agoalie/BajaElecPCB/Baja2027_RPM/jlc_export/Baja2027_RPM_BOM.csv

Comment | Designator | Footprint | LCSC Part #
100n | C1,C2,C3,C4,C5,C6,C8,C12,C14,C15,C18 | C_0402_1005Metric | C1525
10u | C7 | C_0402_1005Metric | C15525
1u | C9,C16,C17 | C_0402_1005Metric | C52923
15p | C10,C11 | C_0402_1005Metric | C1548
4.7u | C13 | C_0402_1005Metric | C23733
LED | D1,D2,D3,D4,D5,D6 | LED_0603_1608Metric | C2286
SS34 | D7,D8 | D_SMA | C8678
USBLC6-2SC6 | D9 | USBLC6-2SC6 | C7519
Fuse | F1,F2 | MF-NSMF050-2_Fuse | C75464
RJ45 | J1,J6,J7,J8,J9,J10 | RJ45 | C385834
JTAG | J2 | JTAG | C2977596
USB_C_Receptacle_USB2.0_14P | J3 | USB_C_Receptacle_GCT_USB4105-xx-A_16P_TopMnt_Horizontal | C2765186
Micro_SD_Card_Det1 | J4 | Sd Card Slot | C91145
DEBUG PORT | J5 | PinHeader_1x04_P2.54mm_Vertical | C32713270
NMOS | Q1,Q2,Q3,Q4,Q5 | SOT-23 | C282405
4.7k | R1,R2 | R_0402_1005Metric | C25900
0 | R3 | R_0402_1005Metric | C17168
10k | R4,R13,R15,R17,R18,R21,R22 | R_0402_1005Metric | C25744
120 | R5 | R_0402_1005Metric | C25079
5.1k | R6,R7 | R_0402_1005Metric | C25905
47k | R8,R9,R10,R11,R12 | R_0402_1005Metric | C25792
470 | R14,R16,R19,R20,R23,R24 | R_0402_1005Metric | C25117
SW_Push | SW1 | SW_Push_1P1T_XKB_TS-1187A | C318884
SW_DPDT_x2 | SW2 | PinHeader_1x03_P2.54mm_Vertical | C3337081
SW_DIP_x01 | SW3 | CHS-01TB_DIPSWITCH | C2680613
24LC00T-I/OT | U1 | 24LC00T_EEPROM_SOT-23-5_MC_MCH | C2062024
STM32F412RETx | U2 | LQFP-64_10x10mm_P0.5mm | C89374
TCAN332 | U3 | TCAN332 | C2671083
XC6206-3.3V | U4 | SOT-23-3 | C2891841
X32258MOB4SI | Y1 | X32258MOB4SI_8MHz_Crystal | C2682775
