agoalie/BajaElecPCB/Baja2027_RPM/3dmodels/RJ45-TH_L15.9-W15.1-H12.6.step

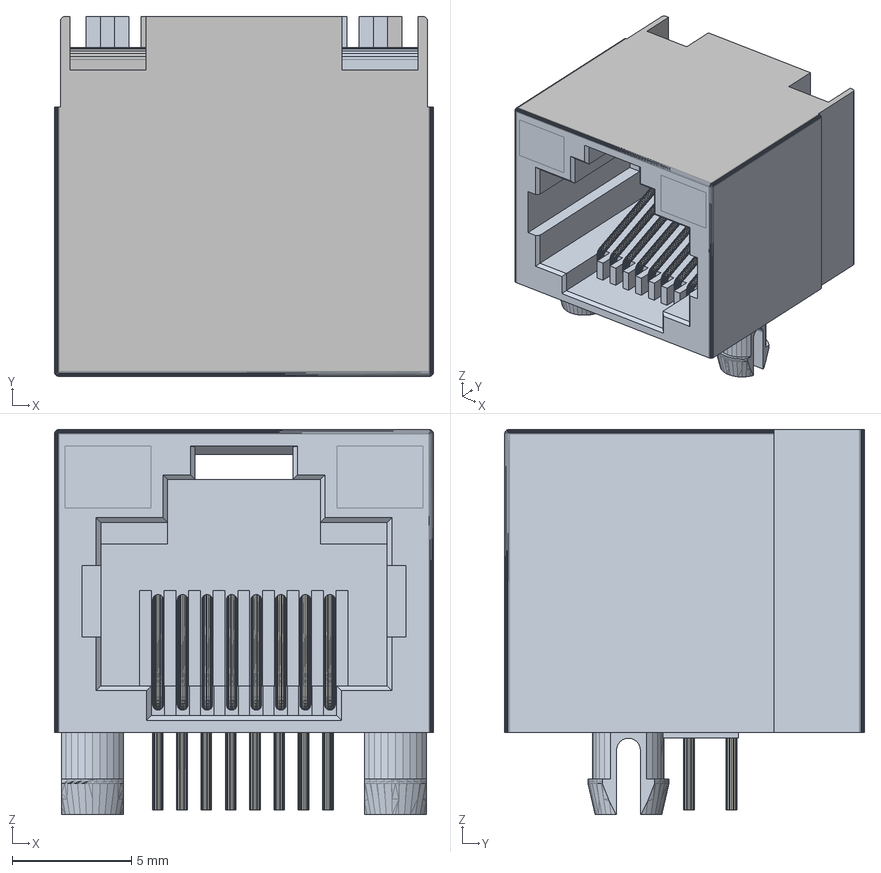
[picture p1: CAD file, 2026-11-05]
Baja2027_RPM/3dmodels/RJ45-TH_L15.9-W15.1-H12.6.step
15.9 x 15.1 x 16.1 mm
