agoalie/BajaElecPCB/Baja2027_RPM/Baja2027_RPM.kicad_pcb

## KiCad design Baja2027_RPM/Baja2027_RPM.kicad_pcb (2026-11-09)

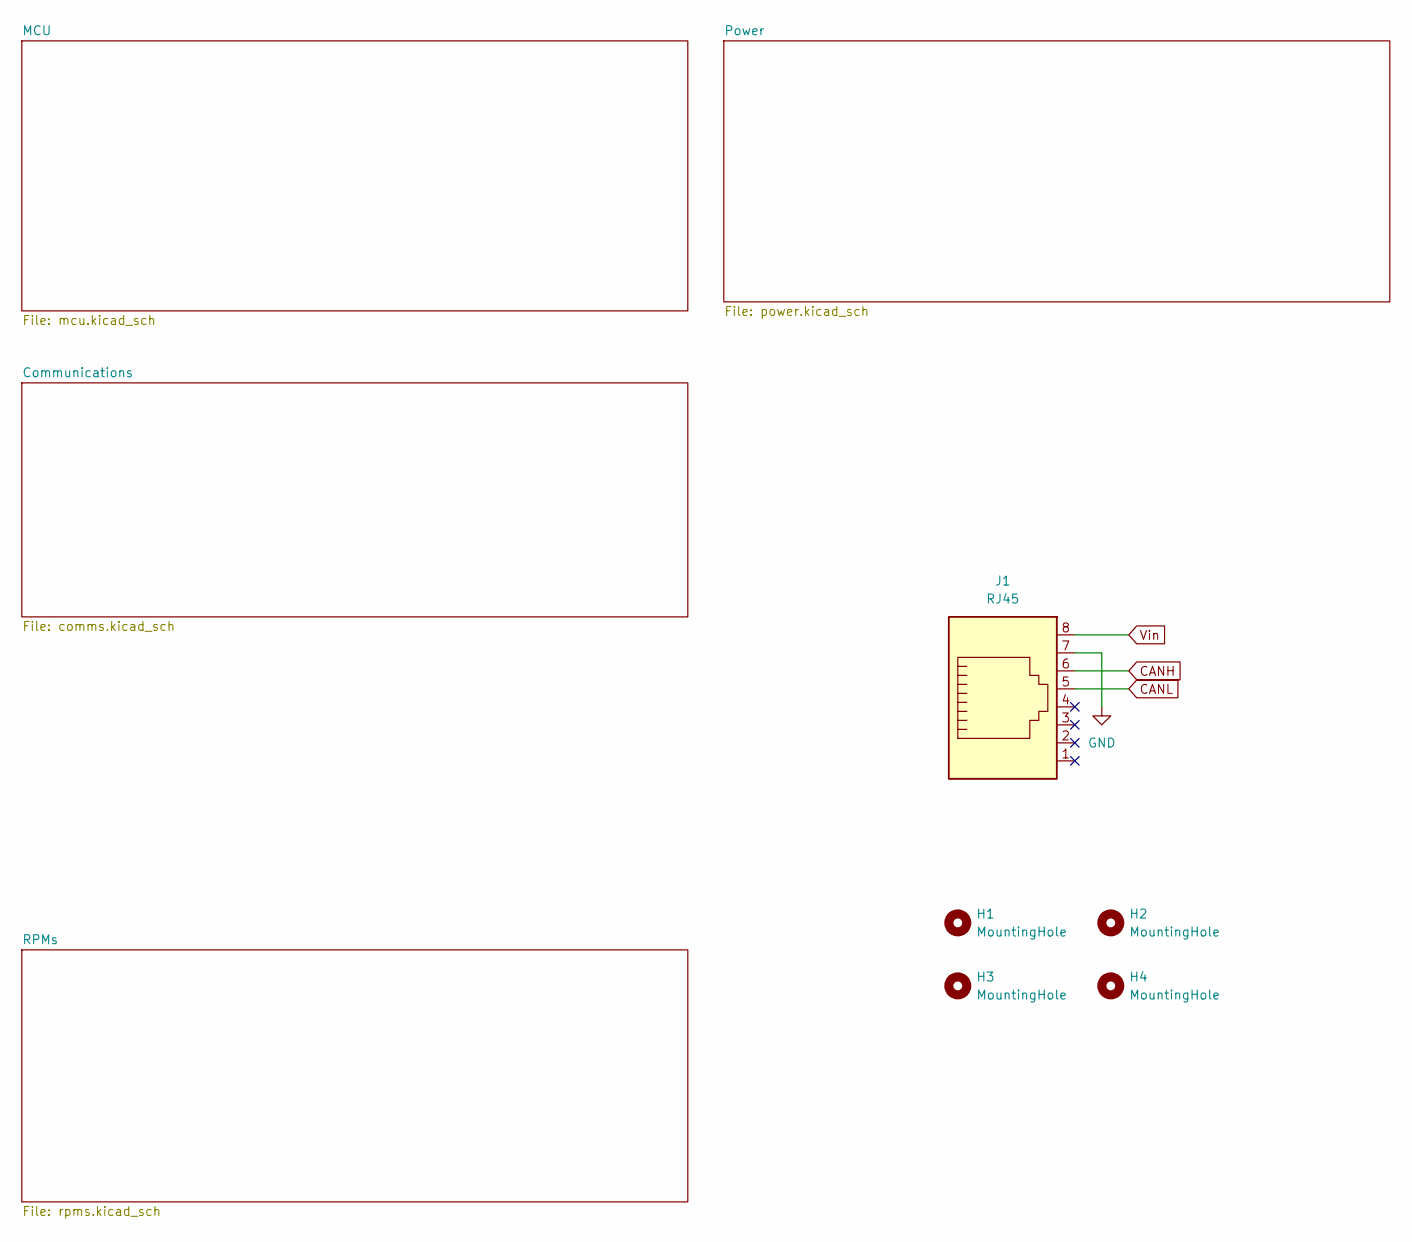
[picture p2: schematic Baja2027_RPM.kicad_sch]

Parts:
H1, H2, H3, H4: MountingHole; MountingHole_4.3mm_M4
J1: RJ45; LCSC PART # C385834

Connections:
CANH: J1.6; also elsewhere on the board
CANL: J1.5; also elsewhere on the board
GND: J1.7; also elsewhere on the board
Vin: J1.8; also elsewhere on the board

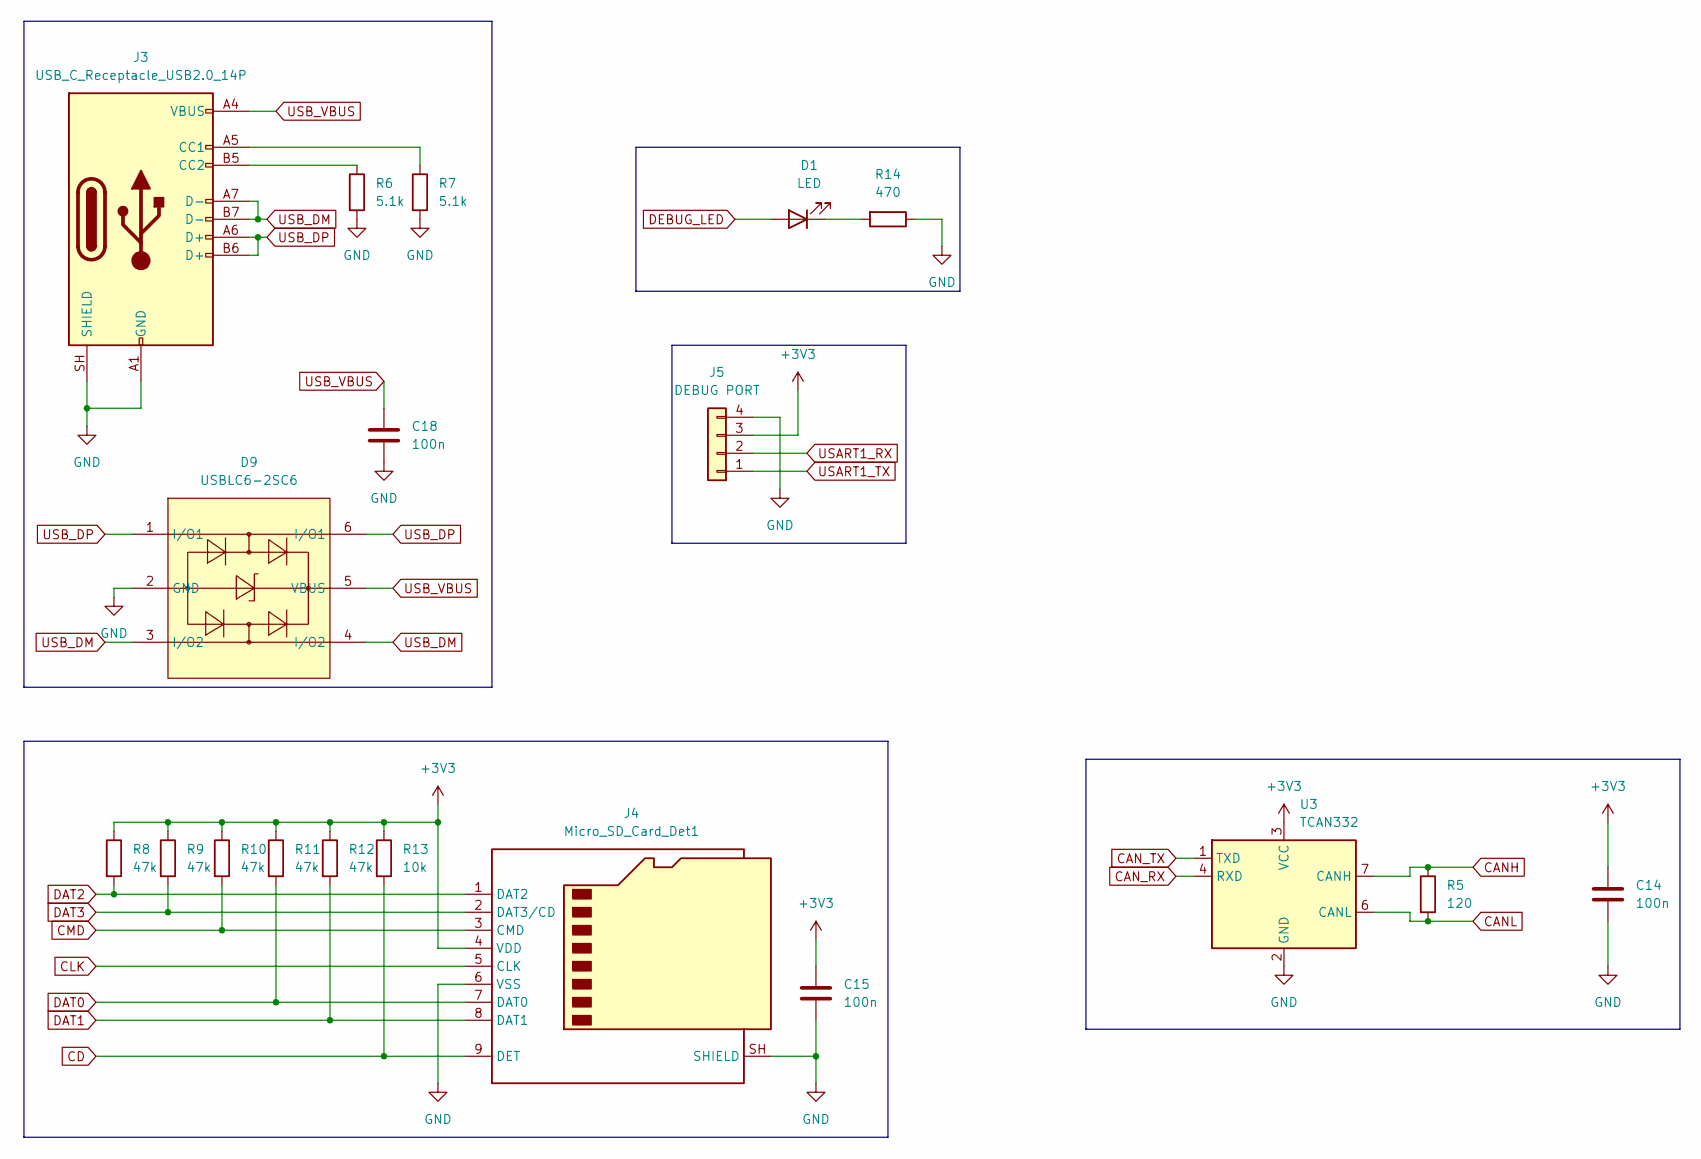
[picture p3: schematic comms.kicad_sch]

Parts:
C14, C15, C18: 100n; C_0402_1005Metric; LCSC PART # C1525
D1: LED; LED_0603_1608Metric; LCSC PART # C2286
D9: USBLC6-2SC6; MPN USBLC6-2SC6; LCSC PART # C7519
J3: USB_C_Receptacle_USB2.0_14P; USB_C_Receptacle_GCT_USB4105-xx-A_16P_TopMnt_Horizontal; LCSC PART # C2765186
J4: Micro_SD_Card_Det1; Sd Card Slot; LCSC PART # C91145
J5: DEBUG PORT; PinHeader_1x04_P2.54mm_Vertical; LCSC PART # C32713270
R5: 120; R_0402_1005Metric; LCSC PART # C25079
R6, R7: 5.1k; R_0402_1005Metric; LCSC PART # C25905
R8, R9, R10, R11, R12: 47k; R_0402_1005Metric; LCSC PART # C25792
R13: 10k; R_0402_1005Metric; LCSC PART # C25744
R14: 470; R_0402_1005Metric; LCSC PART # C25117
U3: TCAN332; LCSC PART # C2671083

Connections:
+3V3: C14.1, C15.1, J4.4 (VDD), J5.3, R8.1, R9.1, R10.1, R11.1, R12.1, R13.1, U3.3 (VCC); also elsewhere on the board
CANH: R5.1, U3.7 (CANH); also elsewhere on the board
CANL: R5.2, U3.6 (CANL); also elsewhere on the board
CAN_RX: U3.4 (RXD); also elsewhere on the board
CAN_TX: U3.1 (TXD); also elsewhere on the board
CD: J4.9 (DET), R13.2; also elsewhere on the board
CLK: J4.5 (CLK); also elsewhere on the board
CMD: J4.3 (CMD), R10.2; also elsewhere on the board
DAT0: J4.7 (DAT0), R11.2; also elsewhere on the board
DAT1: J4.8 (DAT1), R12.2; also elsewhere on the board
DAT2: J4.1 (DAT2), R8.2; also elsewhere on the board
DAT3: J4.2 (DAT3/CD), R9.2; also elsewhere on the board
DEBUG_LED: D1.2 (A); also elsewhere on the board
GND: C14.2, C15.2, C18.1, D9.2 (GND), J3.A1 (GND), J3.A12 (GND), J3.B1 (GND), J3.B12 (GND), J3.SH (SHIELD), J4.6 (VSS), J4.SH (SHIELD), J5.4, R6.2, R7.2, R14.1, U3.2 (GND); also elsewhere on the board
unnamed: D1.1 (K), R14.2
unnamed: J3.A5 (CC1), R7.1
unnamed: J3.B5 (CC2), R6.1
USART1_RX: J5.2; also elsewhere on the board
USART1_TX: J5.1; also elsewhere on the board
USB_DM: D9.3 (I/O2), D9.4 (I/O2), J3.A7 (D-), J3.B7 (D-); also elsewhere on the board
USB_DP: D9.1 (I/O1), D9.6 (I/O1), J3.A6 (D+), J3.B6 (D+); also elsewhere on the board
USB_VBUS: C18.2, D9.5 (VBUS), J3.A4 (VBUS), J3.A9 (VBUS), J3.B4 (VBUS), J3.B9 (VBUS); also elsewhere on the board

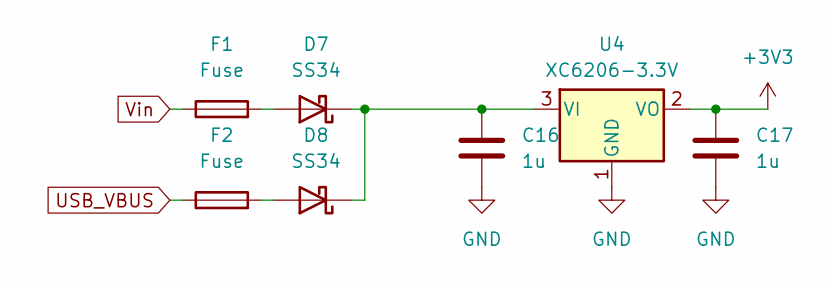
[picture p4: schematic power.kicad_sch]

Parts:
C16, C17: 1u; C_0402_1005Metric; LCSC PART # C52923
D7, D8: SS34; D_SMA; LCSC PART # C8678
F1, F2: Fuse; MF-NSMF050-2_Fuse; LCSC PART # C75464
U4: XC6206-3.3V; SOT-23-3; LCSC PART # C2891841

Connections:
+3V3: C17.1, U4.2 (VO); also elsewhere on the board
GND: C16.2, C17.2, U4.1 (GND); also elsewhere on the board
unnamed: D7.2 (A), F1.2
unnamed: C16.1, D7.1 (K), D8.1 (K), U4.3 (VI)
unnamed: D8.2 (A), F2.2
USB_VBUS: F2.1; also elsewhere on the board
Vin: F1.1; also elsewhere on the board

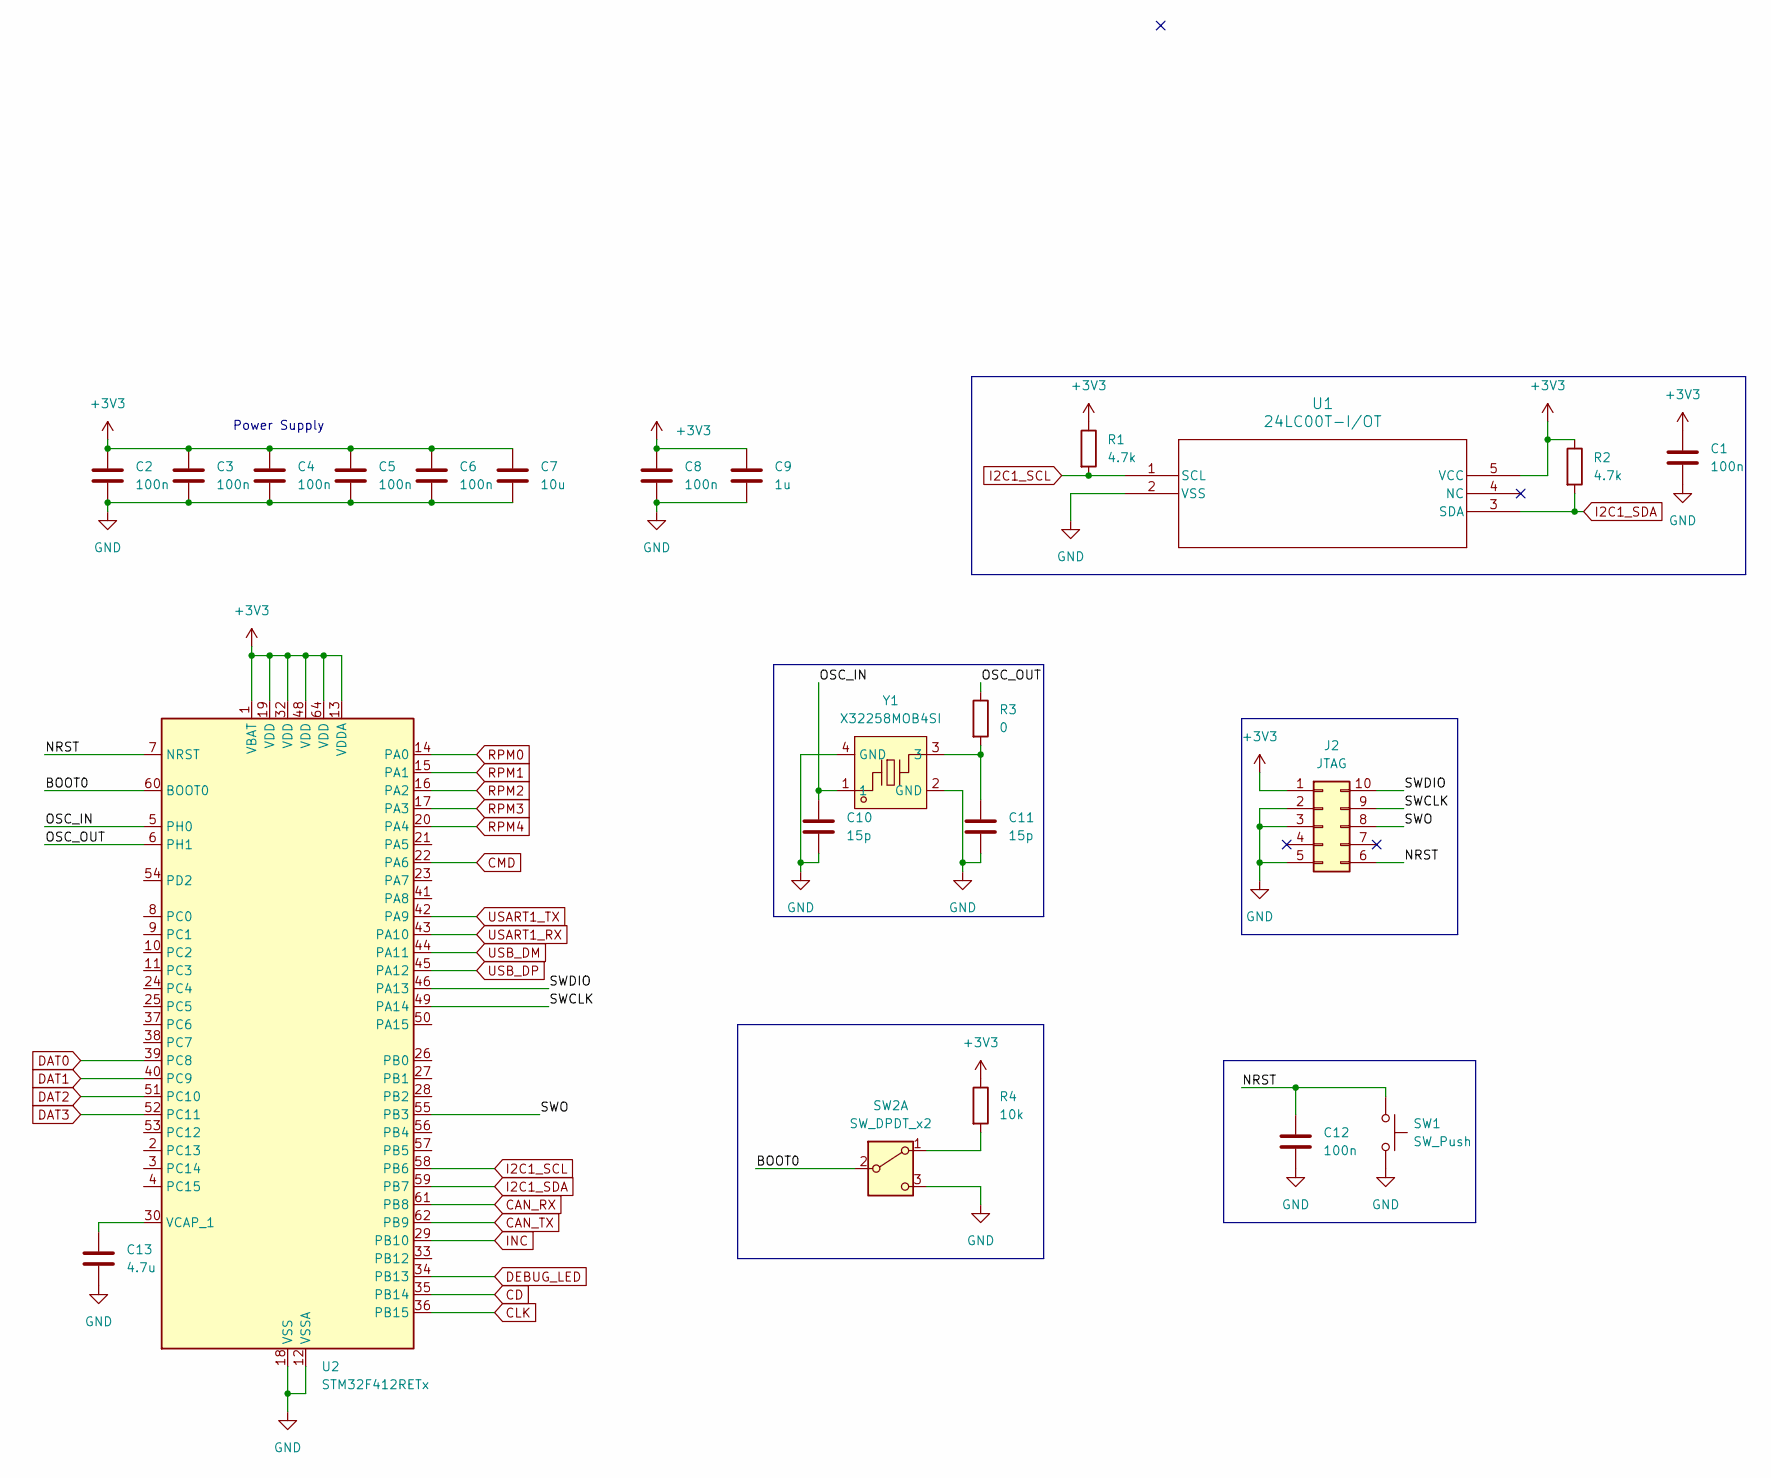
[picture p5: schematic mcu.kicad_sch]

Parts:
C1, C2, C3, C4, C5, C6, C8, C12: 100n; C_0402_1005Metric; LCSC PART # C1525
C7: 10u; C_0402_1005Metric; LCSC PART # C15525
C9: 1u; C_0402_1005Metric; LCSC PART # C52923
C10, C11: 15p; C_0402_1005Metric; LCSC PART # C1548
C13: 4.7u; C_0402_1005Metric; LCSC PART # C23733
J2: JTAG; LCSC PART # C2977596
R1, R2: 4.7k; R_0402_1005Metric; LCSC PART # C25900
R3: 0; R_0402_1005Metric; LCSC PART # C17168
R4: 10k; R_0402_1005Metric; LCSC PART # C25744
SW1: SW_Push; SW_Push_1P1T_XKB_TS-1187A; LCSC PART # C318884
SW2: SW_DPDT_x2; PinHeader_1x03_P2.54mm_Vertical; LCSC PART # C3337081
U1: 24LC00T-I/OT; 24LC00T_EEPROM_SOT-23-5_MC_MCH; LCSC PART # C2062024
U2: STM32F412RETx; LQFP-64_10x10mm_P0.5mm; LCSC PART # C89374
Y1: X32258MOB4SI; X32258MOB4SI_8MHz_Crystal; MPN X32258MOB4SI; LCSC Part C2682775

Connections:
+3V3: C1.1, C2.1, C3.1, C4.1, C5.1, C6.1, C7.1, C8.1, C9.1, J2.1, R1.1, R2.1, R4.1, U1.5 (VCC), U2.1 (VBAT), U2.13 (VDDA), U2.19 (VDD), U2.32 (VDD), U2.48 (VDD), U2.64 (VDD); also elsewhere on the board
/MCU/BOOT0: SW2.2 (B), U2.60 (BOOT0)
/MCU/NRST: C12.1, J2.6, SW1.1, U2.7 (NRST)
/MCU/OSC_IN: C10.1, U2.5 (PH0), Y1.1
/MCU/OSC_OUT: R3.1, U2.6 (PH1)
/MCU/SWCLK: J2.9, U2.49 (PA14)
/MCU/SWDIO: J2.10, U2.46 (PA13)
/MCU/SWO: J2.8, U2.55 (PB3)
CAN_RX: U2.61 (PB8); also elsewhere on the board
CAN_TX: U2.62 (PB9); also elsewhere on the board
CD: U2.35 (PB14); also elsewhere on the board
CLK: U2.36 (PB15); also elsewhere on the board
CMD: U2.22 (PA6); also elsewhere on the board
DAT0: U2.39 (PC8); also elsewhere on the board
DAT1: U2.40 (PC9); also elsewhere on the board
DAT2: U2.51 (PC10); also elsewhere on the board
DAT3: U2.52 (PC11); also elsewhere on the board
DEBUG_LED: U2.34 (PB13); also elsewhere on the board
GND: C1.2, C2.2, C3.2, C4.2, C5.2, C6.2, C7.2, C8.2, C9.2, C10.2, C11.2, C12.2, C13.2, J2.2, J2.3, J2.5, SW1.2, SW2.3 (C), U1.2 (VSS), U2.12 (VSSA), U2.18 (VSS), U2.31 (VSS), U2.47 (VSS), U2.63 (VSS), Y1.2 (GND), Y1.4 (GND); also elsewhere on the board
I2C1_SCL: R1.2, U1.1 (SCL), U2.58 (PB6)
I2C1_SDA: R2.2, U1.3 (SDA), U2.59 (PB7)
INC: U2.29 (PB10)
unnamed: C11.1, R3.2, Y1.3
unnamed: R4.2, SW2.1 (A)
unnamed: C13.1, U2.30 (VCAP_1)
RPM0: U2.14 (PA0); also elsewhere on the board
RPM1: U2.15 (PA1); also elsewhere on the board
RPM2: U2.16 (PA2); also elsewhere on the board
RPM3: U2.17 (PA3); also elsewhere on the board
RPM4: U2.20 (PA4); also elsewhere on the board
USART1_RX: U2.43 (PA10); also elsewhere on the board
USART1_TX: U2.42 (PA9); also elsewhere on the board
USB_DM: U2.44 (PA11); also elsewhere on the board
USB_DP: U2.45 (PA12); also elsewhere on the board

Notes on the sheet:
Power Supply

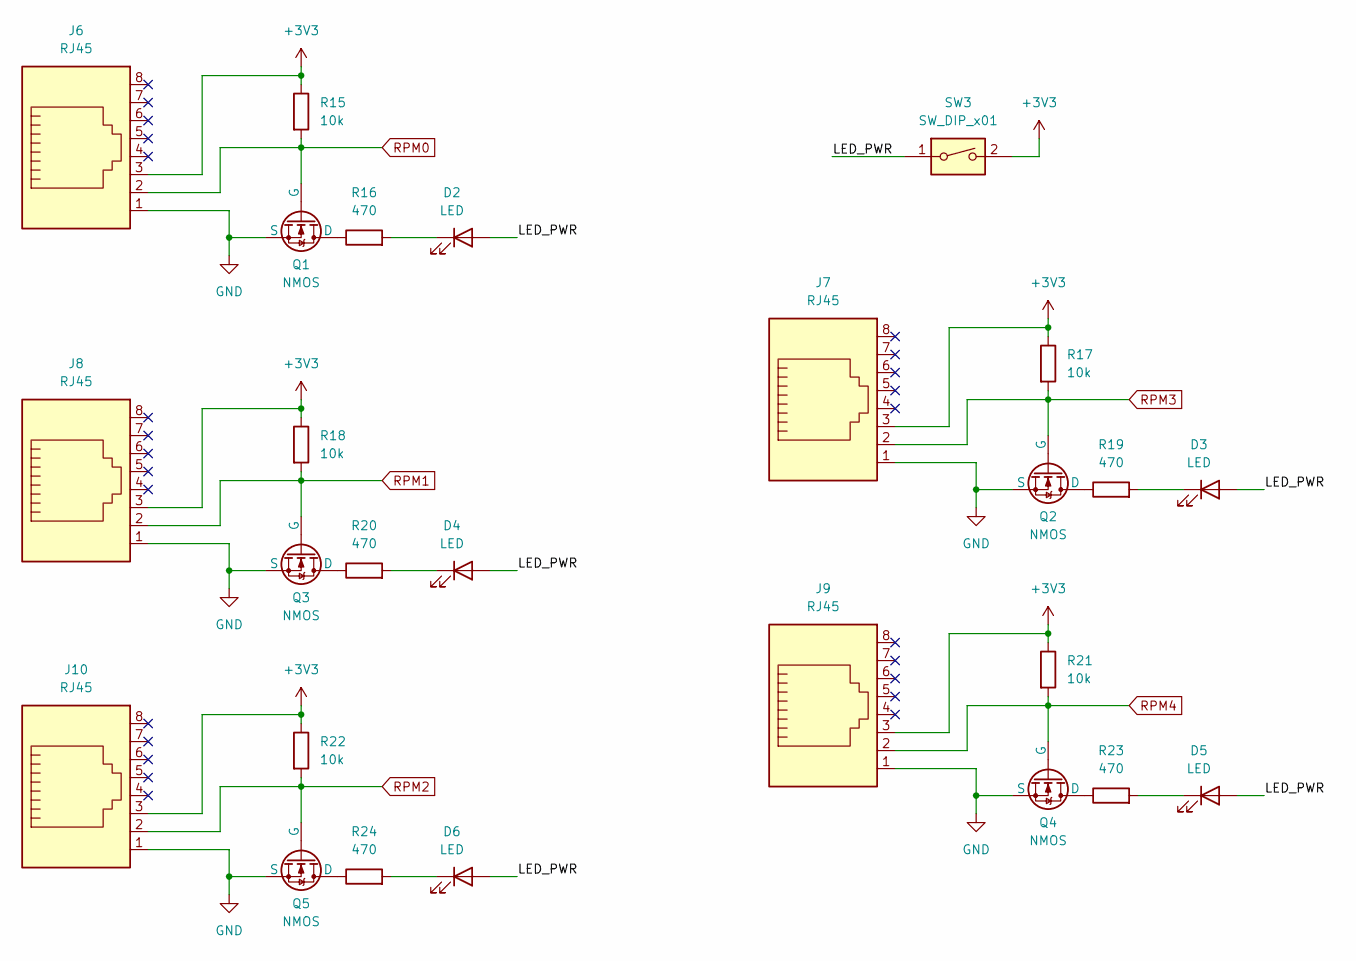
[picture p6: schematic rpms.kicad_sch]

Parts:
D2, D3, D4, D5, D6: LED; LED_0603_1608Metric; LCSC PART # C2286
J6, J7, J8, J9, J10: RJ45; LCSC PART # C385834
Q1, Q2, Q3, Q4, Q5: NMOS; SOT-23; Digikey Part Number 1727-4789-1-ND
R15, R17, R18, R21, R22: 10k; R_0402_1005Metric; LCSC PART # C25744
R16, R19, R20, R23, R24: 470; R_0402_1005Metric; LCSC PART # C25117
SW3: SW_DIP_x01; CHS-01TB_DIPSWITCH; LCSC PART # C2680613

Connections:
+3V3: J6.3, J7.3, J8.3, J9.3, J10.3, R15.1, R17.1, R18.1, R21.1, R22.1, SW3.2; also elsewhere on the board
/RPMs/LED_PWR: D2.2 (A), D3.2 (A), D4.2 (A), D5.2 (A), D6.2 (A), SW3.1
GND: J6.1, J7.1, J8.1, J9.1, J10.1, Q1.2 (S), Q2.2 (S), Q3.2 (S), Q4.2 (S), Q5.2 (S); also elsewhere on the board
unnamed: D2.1 (K), R16.2
unnamed: D3.1 (K), R19.2
unnamed: D4.1 (K), R20.2
unnamed: D5.1 (K), R23.2
unnamed: D6.1 (K), R24.2
unnamed: Q1.3 (D), R16.1
unnamed: Q2.3 (D), R19.1
unnamed: Q3.3 (D), R20.1
unnamed: Q4.3 (D), R23.1
unnamed: Q5.3 (D), R24.1
RPM0: J6.2, Q1.1 (G), R15.2; also elsewhere on the board
RPM1: J8.2, Q3.1 (G), R18.2; also elsewhere on the board
RPM2: J10.2, Q5.1 (G), R22.2; also elsewhere on the board
RPM3: J7.2, Q2.1 (G), R17.2; also elsewhere on the board
RPM4: J9.2, Q4.1 (G), R21.2; also elsewhere on the board

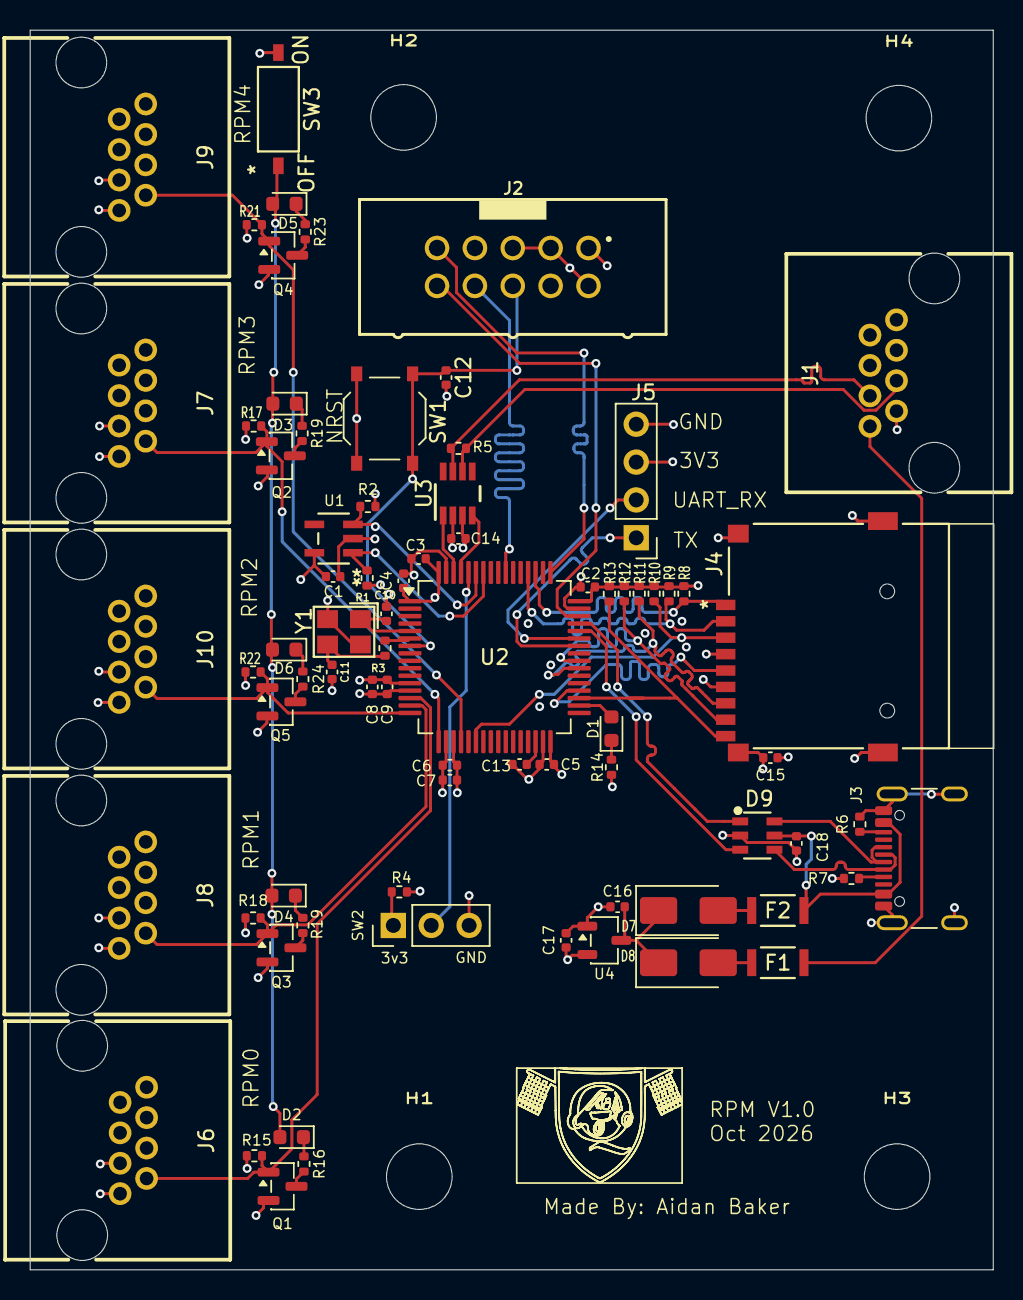
[picture p7: board Baja2027_RPM.kicad_pcb from above]

Board: 4 copper layers, 64.6 x 83.1 mm, 80 parts (0 on the bottom side), 54 nets.
