agoalie/BajaElecPCB/(commit log)

2026-11-05 Add Baja2027_RPM board
    Copied from the team SharePoint (2027/Design/Electrical/Baja2027_RPM).
    KiCad backups, local history, per-user state, and whole-board STEP exports
    are left out by .gitignore.
    [Baja2027_RPM-B_Cu.gbr, Baja2027_RPM-B_Mask.gbr, Baja2027_RPM-B_Paste.gbr, Baja2027_RPM-B_Silkscreen.gbr, Baja2027_RPM-Edge_Cuts.gbr, Baja2027_RPM-F_Cu.gbr, Baja2027_RPM-F_Mask.gbr, Baja2027_RPM-F_Paste.gbr]
2026-11-05 Add visual diff, checks, and JLC export tools
    - tools/pcbdiff.py builds an HTML diff of schematic sheets and PCB layers,
    plus a list of component, net, and placement changes.
    - tools/pcbcheck.py runs ERC, DRC, and the schematic parity check.
    - tools/kicad_jlc_export.py exports JLCPCB gerbers, BOM, and CPL.
    - The PCB checks workflow runs the diff and checks on pull requests.
    - README covers the team workflow and how to add a board.
2026-11-05 Ignore backup files from older KiCad versions
2026-11-05 Remove outdated exports and unused sheets from RPM board
    jlc_export/ is the current fabrication output, so drop the older gerbers,
    BOM, CPL, and position files. counter.kicad_sch and untitled.kicad_sch
    aren't part of the schematic hierarchy, and the netlist is the same without
    them. All of these remain available under the rpm-v1.0 tag.
    [Baja2027_RPM-B_Cu.gbr, Baja2027_RPM-B_Mask.gbr, Baja2027_RPM-B_Paste.gbr, Baja2027_RPM-B_Silkscreen.gbr, Baja2027_RPM-Edge_Cuts.gbr, Baja2027_RPM-F_Cu.gbr, Baja2027_RPM-F_Mask.gbr, Baja2027_RPM-F_Paste.gbr]
2026-11-05 Normalize RPM board file order
    Saved by KiCad 10 with no design changes. Tracks and vias are reordered, and
    two hidden fields gain a font thickness. Committing this stops later saves
    from reordering the whole file.
    [Baja2027_RPM.kicad_pcb]
2026-11-05 Ignore drawing order in pcbdiff change detection
    Reordered tracks marked copper layers as changed even when they looked
    identical. Compare each layer's shapes as a set, keeping group styles so a
    real change such as a new track width is still caught.
2026-11-05 Remove PCB checks workflow
    Run tools/pcbdiff.py and tools/pcbcheck.py locally instead.
2026-11-05 Remove pcbcheck in favor of KiCad's ERC and DRC
    Without the workflow it only repeated what KiCad's own windows do. The README
    now points to those, and to GitHub Desktop for Git since KiCad's menu may not
    appear in this layout.
2026-11-09 updated ESD for usb c port
    [Baja2027_RPM.kicad_pcb, Baja2027_RPM_BOM.csv, comms.kicad_sch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]
